untitled-blockbuster/balancingCube/README.md

### Google Drive : https://drive.google.com/drive/folders/1aKaRFtiWYsuY9H74rAo0-AU3dAib-0p9?usp=sharing
