untitled-blockbuster/balancingCube/Hardware/modeling/metal components/Reaction WL_Main Wheel v2.step

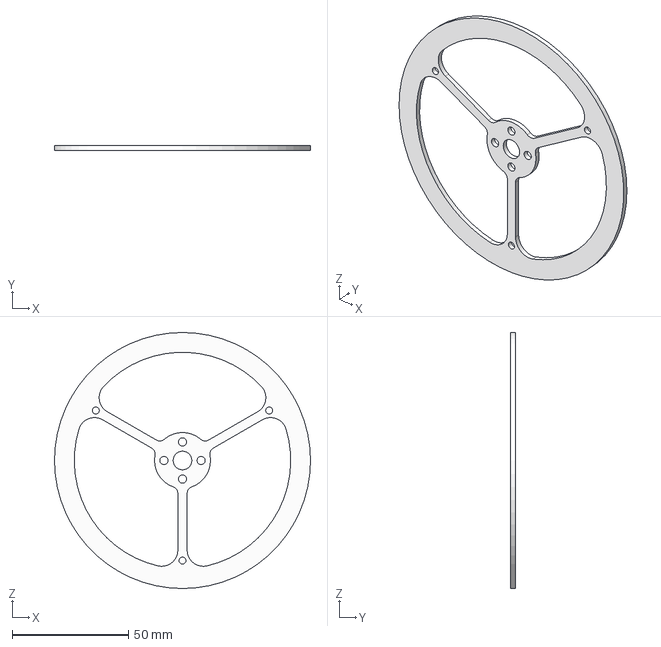
[picture p1: CAD file, 2022-06-05]
Hardware/modeling/metal components/Reaction WL_Main Wheel v2.step
110.0 x 2.00 x 110.0 mm
