untitled-blockbuster/balancingCube/Hardware/modeling/Motor Side.step

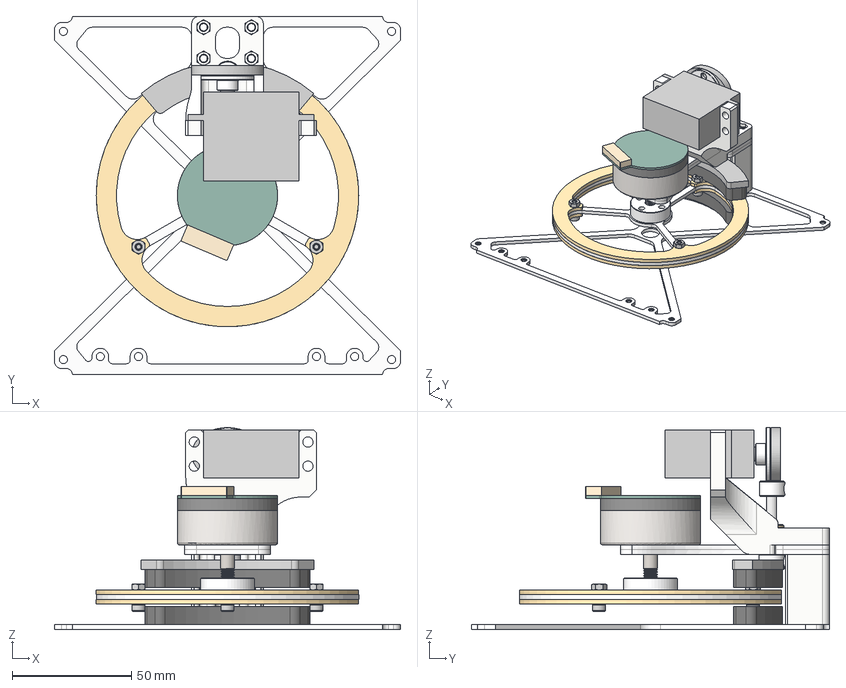
[picture p2: CAD file, 2022-06-05]
Hardware/modeling/Motor Side.step
145.0 x 150.0 x 84.6 mm
Motor_GuideF x 2
motor
bronze bushing
Servo Horns
HS-322HD_1
steel axle 100mm
91390A403_Alloy Steel Cup-Point Set Screw x 2
Reaction WL_Main Wheel
Reaction WL_Additional Wheels x 2
M3 8mm bolts x 3
M3 nuts x 3
92015A113_18-8 Stainless Steel Cup-Point Set Screw
M3 nuts v1 x 4
ServoGF
BreakPad x 2
구성요소4
구성요소5
M_Frame
Motor Frame_Spacer
