untitled-blockbuster/balancingCube/Hardware/modeling/plastic components/ServoGF.step

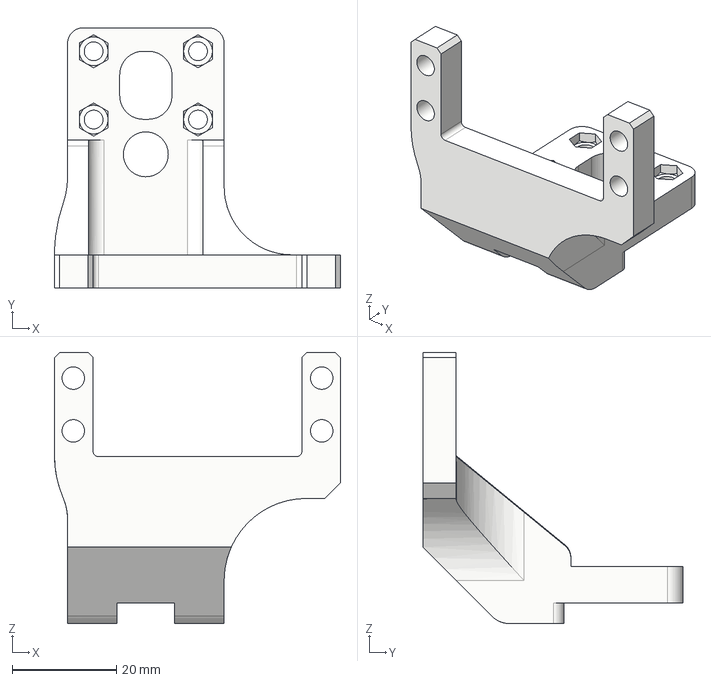
[picture p3: CAD file, 2022-06-05]
Hardware/modeling/plastic components/ServoGF.step
54.8 x 49.9 x 52.0 mm
