untitled-blockbuster/balancingCube/Hardware/modeling/metal components/Reaction WL_Additional Wheels v2.step

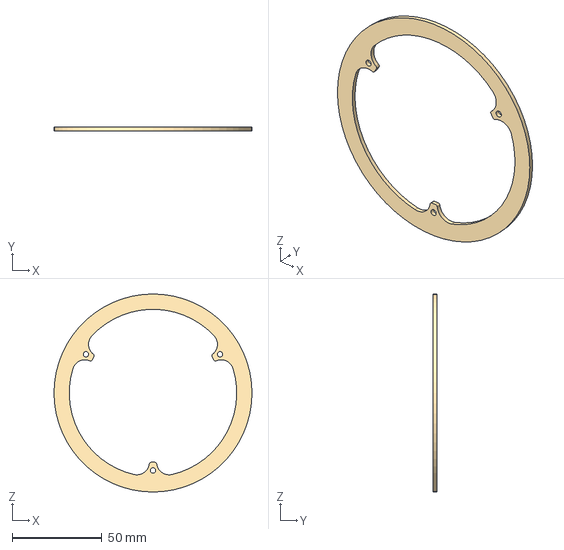
[picture p4: CAD file, 2022-06-05]
Hardware/modeling/metal components/Reaction WL_Additional Wheels v2.step
110.0 x 2.00 x 110.0 mm
