untitled-blockbuster/balancingCube/Hardware/modeling/plastic components/Motor Frame_Spacer v17.step

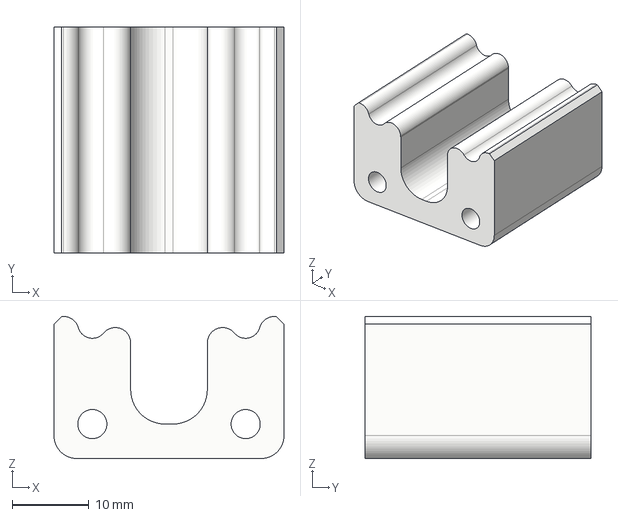
[picture p5: CAD file, 2022-06-05]
Hardware/modeling/plastic components/Motor Frame_Spacer v17.step
30.0 x 29.5 x 18.5 mm
