untitled-blockbuster/balancingCube/Hardware/modeling/metal components/CAM block.step

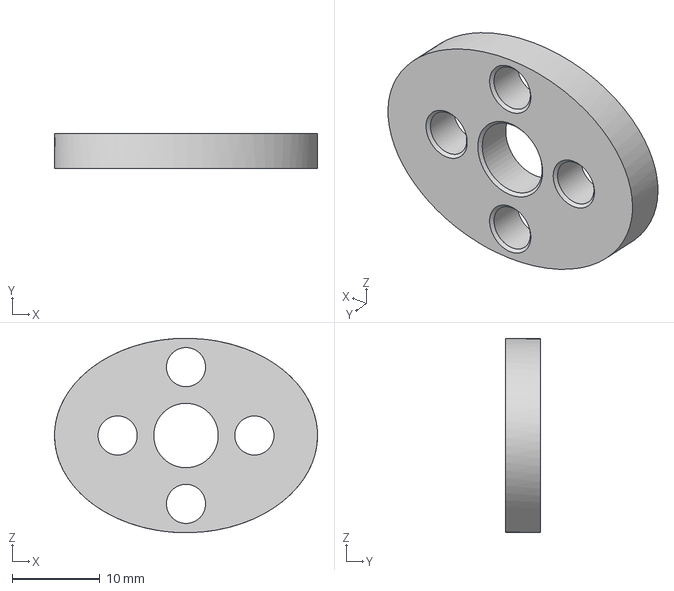
[picture p6: CAD file, 2022-06-05]
Hardware/modeling/metal components/CAM block.step
30.0 x 4.00 x 22.2 mm
