untitled-blockbuster/balancingCube/Hardware/modeling/metal components/Motor_GuideF v2.step

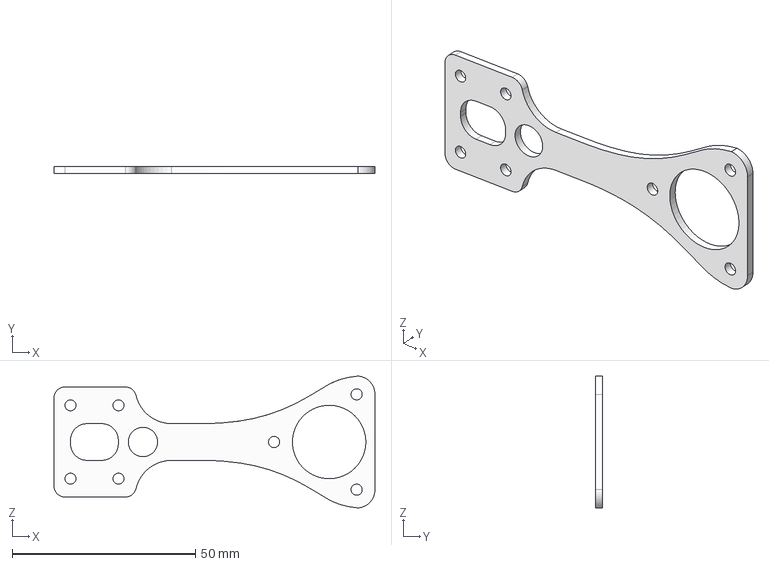
[picture p7: CAD file, 2022-06-05]
Hardware/modeling/metal components/Motor_GuideF v2.step
87.5 x 2.00 x 36.0 mm
