untitled-blockbuster/balancingCube/Hardware/modeling/metal components/M_Frame v7.step

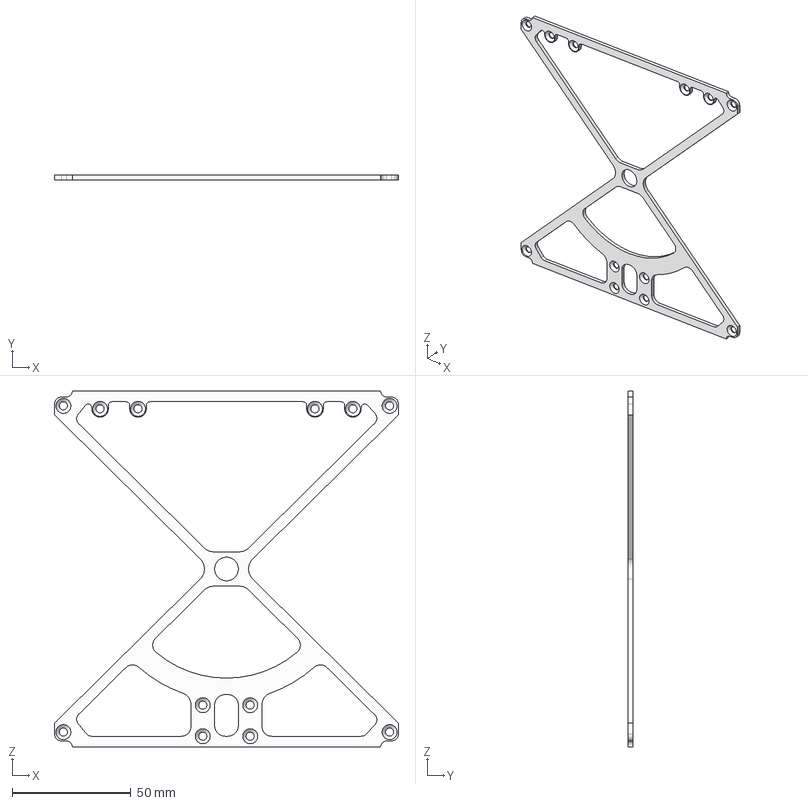
[picture p8: CAD file, 2022-06-05]
Hardware/modeling/metal components/M_Frame v7.step
145.0 x 2.00 x 150.0 mm
