untitled-blockbuster/balancingCube/Hardware/modeling/metal components/Break GF.step

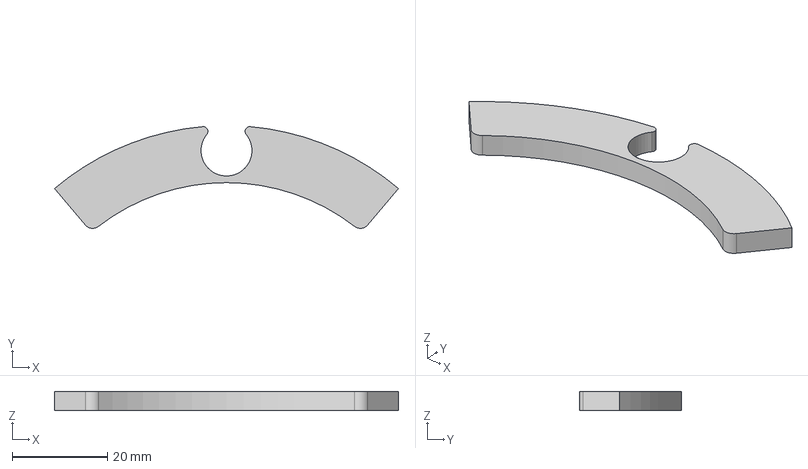
[picture p9: CAD file, 2022-06-05]
Hardware/modeling/metal components/Break GF.step
72.3 x 21.4 x 4.00 mm
