untitled-blockbuster/balancingCube/(threads)

Thread 4 (2022-04-14):

웹사이트 효과

30302, 2022-04-14:
웹사이트를 들어가면 화면이 갈라지는 효과.
웹사이트에 접속할 때의 효과로 일반 구글 웹사이트와는 차별된 효과로 좀 더 사이트에 집중이 되고 완성도를 높이는데 도움이 될 것 같습니다.

웹사이트 EX)http://nexis-design.com/index_new.asp

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
p

Thread 9 (2022-04-14):

웹페이지 레이아웃

30302, 2022-04-14:
웹페이지 레이아웃 틀, 대략적인 형태
심플하면서 보기 편한 형태로 레이아웃 설정
웹사이트:https://ko.wix.com/website-template/view/html/2855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

Thread 21 (2022-05-14):

전자회로 구성시 요구사항

dgun7140, 2022-05-14:
**--필수 필요--**
Tennsy4.0 실드 온보드 포트
모터 커넥터
서보 커넥터 (반력 휠 브레이크)
MPU9250 커넥터
상태표시, 전원공급 led
배터리 전원 포트
외부전원 포트
블루투스 포트

_--선택--_
*펑션 버튼'

**-- 최대 소비 전류 도출--**

teensy4.0 100mA (600Mhz 동작시)
MPU9250 3.1mA*3
HS-322HD Servo Idle current: 180mA, Stall current 800mA*3
Nidec 24H Idle current 80mA, Stall current 1.5A (예상)*3

**=이론상 최대 전력 7009.3mA = 7.0093A , 7A**

--------------------------------------------------------------------------------------

_(이하는 이상적 환경일때)_

-일반적 3축 동작시
	HS-322HD Servo Idle current: 180mA
	+Nidec 24H Idle current 100mA(예상)*3

	=1~ 1.5A 예상. 최대 2A(≤ 1sec)

-Stand up 동작시
	HS-322HD Servo 스톨 전류 800mA*(2 or 1) (< 1sec)
	+ Nidec 24H 0.5초간 1A, 이후 스톨 상태 1.5A*(2 or 1)

	=순간 최대전력 4.6A. (< 0.8sec)

**베터리 순간 최대 출력전류: 15.0A (≤ 1.5sec), 연속 8.0A = 문제 없음.**

--------------------------------------------------------------------------------------

[PCB 설계시 참조]

1. 모터류 포트 대전력 설계,
2. 신호 그라운드 일치, 노이즈 GND카퍼.
3 .MPU 전원노이즈, 모터 역 서지 CAP 포함.

**로직 3.3V
**내부 전원 5V

*서보모터는 별개의 전원 공급 회로(또는 장치) 필요 (2.4A 이상)
