untitled-blockbuster/balancingCube/(commit log)

2022-03-31 Aspire에서 모터 프레임 toolpath를 만듬
    브라켓쪽 라운드 : 2.5mm
2022-03-31 하드웨어의 README 변경
    Aspire 사용하면서 설정한 규격과 사용자 팁, 의문점 정리함
2022-04-07 브레이크 시스템의 2가지 방법
    왼쪽은 기어를 사용한 집게 형식, 오른쪽은 디스크 브레이크 방식임
2022-04-07 구매 목록
    테스트를 위해 사야할 것과 2차 구매 때 사야할 것
    마크다운을 써보고 싶음
2022-04-07 Delete 구매 목록
    마크다운 쓰려면 확장자가 .md여야 한다는 걸 깨달음
2022-04-07 구매목록
    마크다운 파일을 만들음 (확장자 .md)
    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
2022-04-07 Update 구매 목록.md
    카운터싱크 드릴 날 추가
    마크다운 문법 수정 (띄어쓰기)
2022-04-07 Delete 구매 목록.md
    Hardware에다 만들어서 삭제함
    balancingCube 안에 만들 예정
2022-04-07 Create 구매목록.md
    Hardware 안에 있던거 꺼내옴
2022-04-07 Update 구매목록.md
    11자 변환 콘센트 추가
2022-04-09 Update 구매목록.md
    칩 거름망 추가
2022-04-09 Update 구매목록.md
    접시머리 볼트 링크 추가
2022-04-09 접시머리 볼트 규격
    ㅇㅇ
2022-04-10 Update 구매목록.md
    테스트용 물품 진행사항 추가
2022-04-11 테스트용 고정판 모델링 파일
    베어링 내경 5mm 에 외경 10mm 쓸 생각으로 만듬
    프레임에 5파이 철원통을 고정하고 베어링을 양쪽에 끼울 생각
    3D프린터로 뽑을 생각으로 만듬
    [테스트용 고정판.ipt]
2022-04-11 Create CNC 기계 사용법 (알루미늄 판재 2T)
    차차 수정할 예정
2022-04-14 add gitignore file
    최상단 wrokspace 설정용 gitignore
2022-04-14 install get_it
    flutter web에서의 URL routing을 위한 getit 설치, 의존성 주입
2022-04-14 edit url-routing
    url 기반 다중페이지 이동 구현
2022-04-24 init workspace
    platform io, teensy 4.0, arduino framework
2022-05-03 make folders and add files
    1축, 3D프린터, CNC기계 폴더를 만들고 각 파일을 부품별로 정리함
    [Additional WL 도면.dxf, Break holder 도면 v1 시트1.dxf, Frame_M.dxf, Motor Frame_Spacer v8.stl, Motor_GF도면.dxf, Non_Frame.dxf, Reaction WL 도면.dxf, TestBed 도면 v0 시트1.dxf]
2022-05-03 Delete 나사.png
    없어도 됨
2022-05-05 import librarys for 1axis
    import i2c, mpu6050
2022-05-05 edit pid controll labrary
    edit parameters, calculating
2022-05-05 write source code
    read 6050 sensor value and control motor(analogWrite) with PID control
2022-05-06 complete tuning
    PID값 튜닝 완료, 계산 방식 설정
2022-05-07 'CNC기계' 디렉토리 이름 변경
    [Additional WL 도면.dxf, Break holder 도면 v1 시트1.dxf, Frame_M.dxf, Motor_GF도면.dxf, Non_Frame.dxf, Reaction WL 도면.dxf, TestBed 도면 v0 시트1.dxf]
2022-05-07 필요 없는거 삭제, readme 수정
    [테스트용 고정판.ipt]
2022-05-07 하드웨어 폴더 정리
2022-05-08 edit lib(queue, PID)
    create Queue algorithm
    edit PID integ
2022-05-09 readme 수정
2022-05-10 Delete Motor Frame_Spacer v8.gcode
    ipt 파일이 있으면 stl도 지울 예정
2022-05-10 Delete 서보모터 홀더_1x.gcode
    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
2022-05-10 Delete test_bed_1x.gcode
    ipt만 남기고 나머지 지움
2022-05-10 Delete Hardware/1축/3D프린터/테스트용 고정판/OldVersions directory
    있을 필요 없음
    [테스트용 고정판.0009.ipt]
2022-05-10 Delete test_bed_2x.gcode
    ipt 남기고 나머지 지움
2022-05-10 Delete 테스트용 고정판.stl
    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
    [테스트용 고정판.stl]
2022-05-10 Delete Merged_모터 가이드 3mm.txt
    crv3d 파일만 남기고 지움
2022-05-10 Delete Merged_모터 가이드 6mm.txt
    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
2022-05-10 Delete Motor_GF도면.dxf
    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
    [Motor_GF도면.dxf]
2022-05-10 Delete Break holder 도면 v1 시트1.dxf
    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
    [Break holder 도면 v1 시트1.dxf]
2022-05-10 Delete break holder 3mm.txt
    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
2022-05-10 Delete break holder 6mm.txt
    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
2022-05-10 Delete Non_Frame.dxf
    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
    [Non_Frame.dxf]
2022-05-10 Delete Frame_M.dxf
    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
    [Frame_M.dxf]
2022-05-10 Delete 벡터 합치기 몰라서 일일이 선택했던 프레임.crv3d
    기록용이어서 지움
2022-05-10 Delete 테스트용 프레임 6mm.txt
    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
2022-05-10 Delete 테스트용 프레임 3mm.txt
    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
2022-05-10 Delete TestBed 도면 v0 시트1.dxf
    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
    [TestBed 도면 v0 시트1.dxf]
2022-05-10 Delete Hardware/1축/CNC/휠/중심 휠 directory
    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
    [Reaction WL 도면.dxf]
2022-05-10 Delete Hardware/1축/CNC/휠/무게 휠 directory
    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
    [Additional WL 도면.dxf]
2022-05-10 Delete 휠 6mm.txt
    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
2022-05-10 Delete 휠 3mm.txt
    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
2022-05-10 gitignore 수정사항 실험
    [Additional WL 도면.dxf, Reaction WL 도면.dxf]
2022-05-10 Delete Motor Frame_Spacer v8.gcode
    ipt 파일만 남기고 지움
2022-05-10 Delete Motor Frame_Spacer v8.stl
    for gitignore test
    [Motor Frame_Spacer v8.stl]
2022-05-11 Edit librarys
    change struct to class
    pid and Queue lib
2022-05-14 Add files via upload
    1축 제어용 모델링 파일
    Fusion 360 사용
    [M-side assembly V2 v15.f3z]
2022-05-14 refoldering
    1축과 3축을 구분할 필요성이 없는 것 같아 파일들을 꺼내고 1축 폴더를 삭제함
    [테스트용 고정판.ipt]
2022-05-20 include librarys for last model
    add PID, Queue
    remove wire
2022-05-22 edit gitignore and add Motor_GF 도면.gxf
    [Motor_GF도면.dxf]
2022-05-22 organize files, edit gitignore and readme
    [Break GF.step, CAM block.step, M-side assembly V2 v15.f3z, M_Frame v7.step, Motor Frame_Spacer v17.step, Motor Side.step, Motor_GF도면.dxf, Motor_GuideF v2.step]
2022-06-06 edit library
    remove unnecessary Queue lib,
    creating motor controll lib(it has PID, MPU6050)
2022-06-26 create motor controller lib, edit PID lib
2022-06-27 Update and rename Google_Drive.md to README.md
    google drive link 리드미
2022-07-03 edit PID library apply clamping, fix init
2022-07-03 create mode, create system by balancing every motor side edge(use for loop)
2022-07-09 update motorController add weight point and some functions rename some var and functions and apply offset
2022-07-09 complete tune delete unnecessary print command change to for-each loop create set offset function
2022-07-09 apply 1Axis mode call 1axis setup and loop func, and use btn input to reset or set offset cube
    [main.cpp]
